osafune/xiaowand/README.md

# XIAO WAND

## Overview
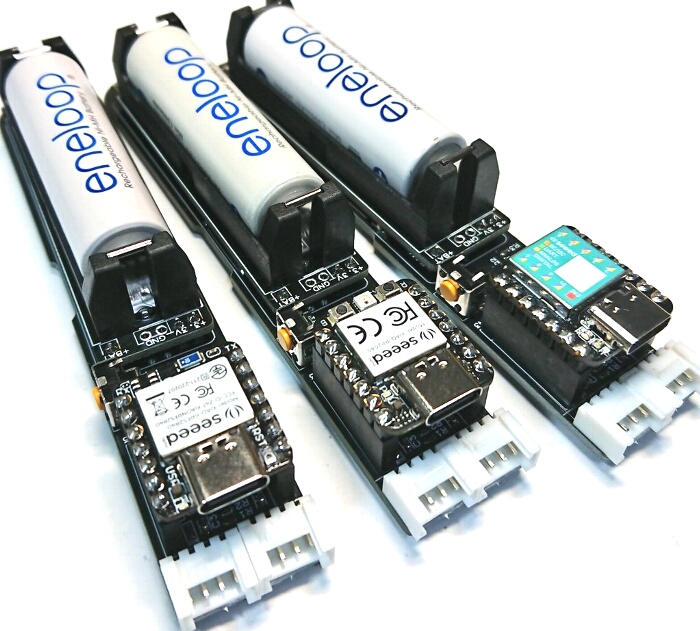
[picture p1: img/xiaowand_top2.jpg]
img_top


XIAO WANDはSeeedstudioの小型MCUモジュール "XIAO" シリーズ専用のI/O・電源ベースボードです。  
W20mm×L115mm×H22mmのコンパクトサイズに、高出力・高効率の電源モジュール"[ENEBATT](https://osafune.github.io/enebatt_jp.html)"を搭載しており、単三形ニッケル水素電池1本でGroveセンサーモジュールやLEDテープの制御が可能です。  
専用のArduino IDE用ライブラリ「xiaowand_lib」では、ボードの電源制御およびボタンイベント取得、LEDパターン点滅、MMLバックグランド再生の機能が提供され、XIAO BLEと組み合わせれば簡単にBluetooth制御の電飾ユニットが製作できます。

- ボード搭載ペリフェラル
	* 電源モジュール×1 (Ni-MH AA 1cell→3.3V昇圧)
	* タクタイルスイッチ×1 (電源ボタン・ユーザーボタン兼用)
	* Groveコネクタ×2 (LED/UART用×1, I2C/PIO/AIN用×1)
	* 圧電ブザー×1
	* μSD/TFカードスロット×1

- 対応ボード
	* [Seeeduino XIAO](https://wiki.seeedstudio.com/Seeeduino-XIAO/) ボードマネージャー 1.8.3以降
	* [XIAO RP2040](https://wiki.seeedstudio.com/XIAO-RP2040/) ボードマネージャー 2.7.2以降
	* [XIAO BLE(Sense)](https://wiki.seeedstudio.com/XIAO_BLE/) ボードマネージャー 1.0.0 または 2.6.1以降
  * XAIO ESP32C3 対応予定

- 外形サイズ
	* 幅20.5mm×長さ115mm×厚み22mm（電池および突起部含む）  
	固定用ネジ穴 φ3.1×2

## Board Layout
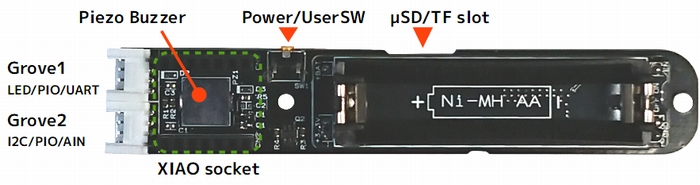
[picture p2: img/xiaowand_board.jpg]
img_board
  

- **Power/UserSW**  
電源ON/OFFおよびユーザー入力（クリック、長押し）のタクタイルスイッチです。ステート制御は`xiaowand_lib`で行います。  

- **Grove1 (LED/PIO/UART)**  
NeoPixelテープ等を接続することを想定したコネクタです。ENEBATTからの直接出力で連続3.3V/500mA(ピークで1000mA)を使うことができます。  

  |PIN|信号名|内容|
  |---|---|---|
  |1|D7/RXD|PIO_D7またはUART-RXD|
  |2|D6/TXD|PIO_D6またはUART-TXD|
  |3|VLED|ENEBATTからの3.3V出力|
  |4|GND|GND|

- **Grove2 (I2C/PIO/AIN)**  
センサーやスイッチ等を接続することを想定したコネクタです。XIAOモジュールの3.3Vで駆動され、USBが接続されている間は常に電源が供給されます。  

  |PIN|信号名|内容|
  |---|---|---|
  |1|D5/SCL|PIO_D5、I2C-SCLまたはAIN5|
  |2|D4/SDA|PIO_D4、I2C-SDAまたはAIN4|
  |3|3.3V|XIAOモジュールからの3.3V出力(max100mA)|
  |4|GND|GND|

  ※アナログ入力はXIAO RP2040では使えません  

- **Piezo Buzzer**  
オンボード搭載のピエゾブザーです。  

- **μSD/TF slot**  
microSD/TFカードを挿入するスロットです。XIAOモジュールの3.3Vで駆動され、USBが接続されている間は常に電源が供給されます。  

## Documents
- [XAIO WAND プログラミングガイド](xiaowand_programming_guide_jp.md)

## Resources
- [XIAO WAND ライブラリ(Arduino IDE用)](src/xiaowand_lib.ino)
- [回路図(Rev.B)](pcb/xiaowand_pcb_revb_schem.pdf)
- [ENEBATT](https://osafune.github.io/enebatt_jp.html)

## Buy now
スイッチサイエンス
[XIAO WAND - XIAO用電源ベースボード](https://www.switch-science.com/products/8910)

## QandA
- Q. 充電機能はありますか？  
A. 保安のため充電機能は搭載されていません。別途充電器をご利用ください。

- Q. XIAO ESP32C3には対応しますか？  
A. ハードウェア上は問題なく使用できます。xiaowand_libはアップデートで対応予定です。

- Q. Arduino IDE 2.xで使用できますか？  
A. 現時点では動作確認をしていません。アップデートで対応予定です。

## Contant Us
- [GitHub - Shun OSAFUNE](https://github.com/osafune)
- Mail - support@j7system.jp
