osafune/xiaowand/img/xaiowand.jpg

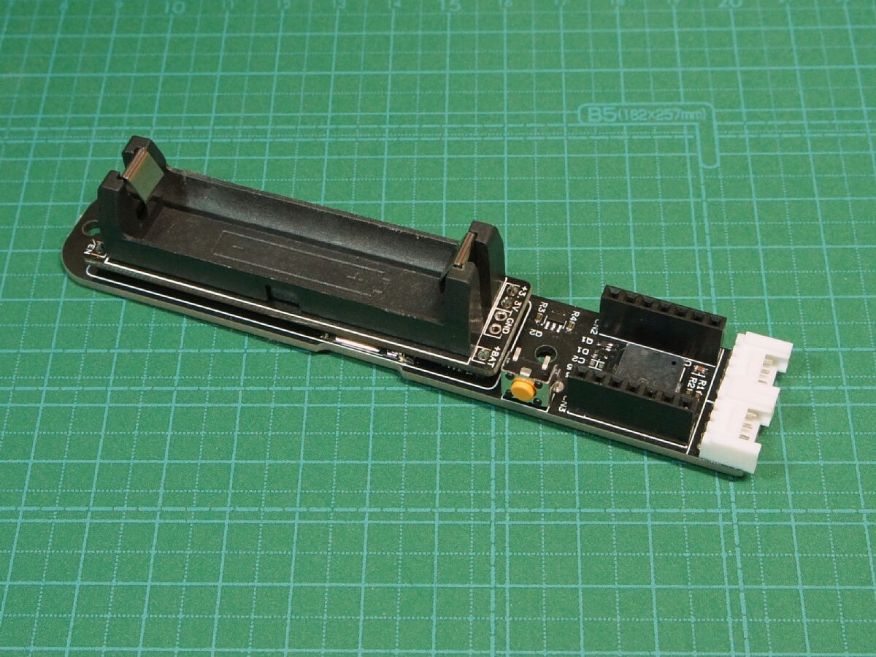
img/xaiowand.jpg
