osafune/xiaowand/img/xiaowand_top.jpg

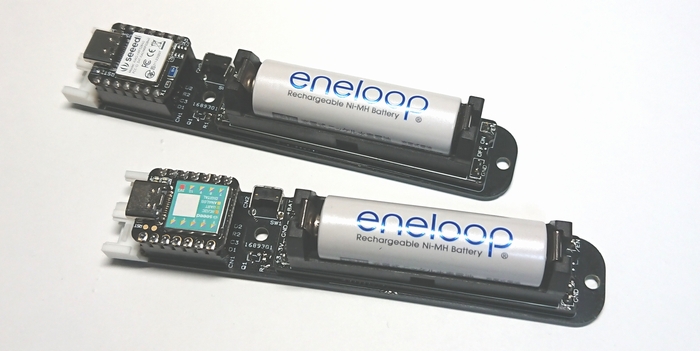
img/xiaowand_top.jpg
