osafune/xiaowand/pcb/xiaowand_pcb_revb_schem.pdf

# XIAO WAND

## Seeeduino XIAO

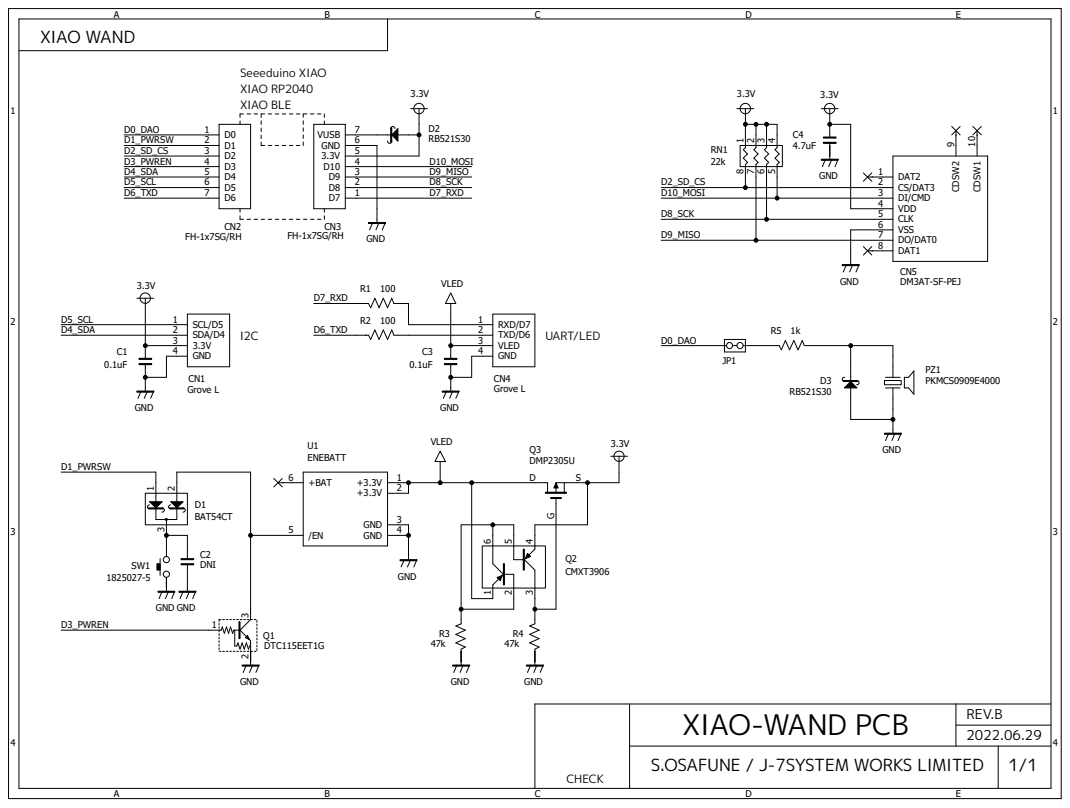
[picture p6: page 1]
